Capstone2017-G4/411Practicum/Final BOM.pdf

# Bill Of Material

Component Name | Quantity | Per Unit Cost | Cost | Component Name | Quantity | Per Unit Cost | Cost
Resistors | | | | IC Bases
10k | 1 | $0.01 | $0.01 | 28-PIN | 1 | $0.50 | $0.50
750k | 1 | $0.01 | $0.01 | 18-Pin | 2 | $0.25 | $0.50
1M | 1 | $0.01 | $0.01 | 16-pin | 1 | $0.50 | $0.50
220 | 4 | $0.01 | $0.04 | 6-pin GPIO header | 1 | $0.50 | $0.50
47k | 1 | $0.01 | $0.01 | 2x3 6-pin ISP header | 1 | $0.50 | $0.50
Capacitors | | | | Miscellaneous
0.1u | 9 | $0.01 | $0.09 | CRYSTAL 16MHz | 1 | $0.24 | $0.24
10u | 6 | $0.01 | $0.06 | TX/RX module pair | 1 | $1.83 | $1.83
22p | 2 | $0.01 | $0.02 | RED LED | 2 | $0.10 | $0.20
Integrated Circuits | | | | 2-PIN PUSH BUTTON | 2 | $0.50 | $1.00
7805T | 2 | $0.20 | $0.40 | MALE BURGE 2-PIN | 1 | $0.50 | $0.50
ATMEGA ATMEL 328PU | 1 | $7.68 | $7.68 | PCB CONNECTOR 2-PIN | 4 | $0.50 | $2.00
L293D | 1 | $0.90 | $0.90 | ACCELEROMETER | 1 | $14.99 | $14.99
HT12E | 1 | $1.75 | $1.75 | Battery 9V | 10 | $3.00 | $30.00
HT12D | 1 | $1.95 | $1.95 | ROBOT CHASSIS W/ 2 MOTORS | 1 | $10.99 | $10.99
| | | | SOLDERING LED | 4 | $0.20 | $0.80
| | | | CONNECTING WIRE | 10 | $0.01 | $0.10
| | | | TOTAL | | $47.66 | $78.07
