Capstone2017-G4/411Practicum/Transmitter_11-16.brd

## EAGLE design Transmitter_11-16.brd (2017-11-16)

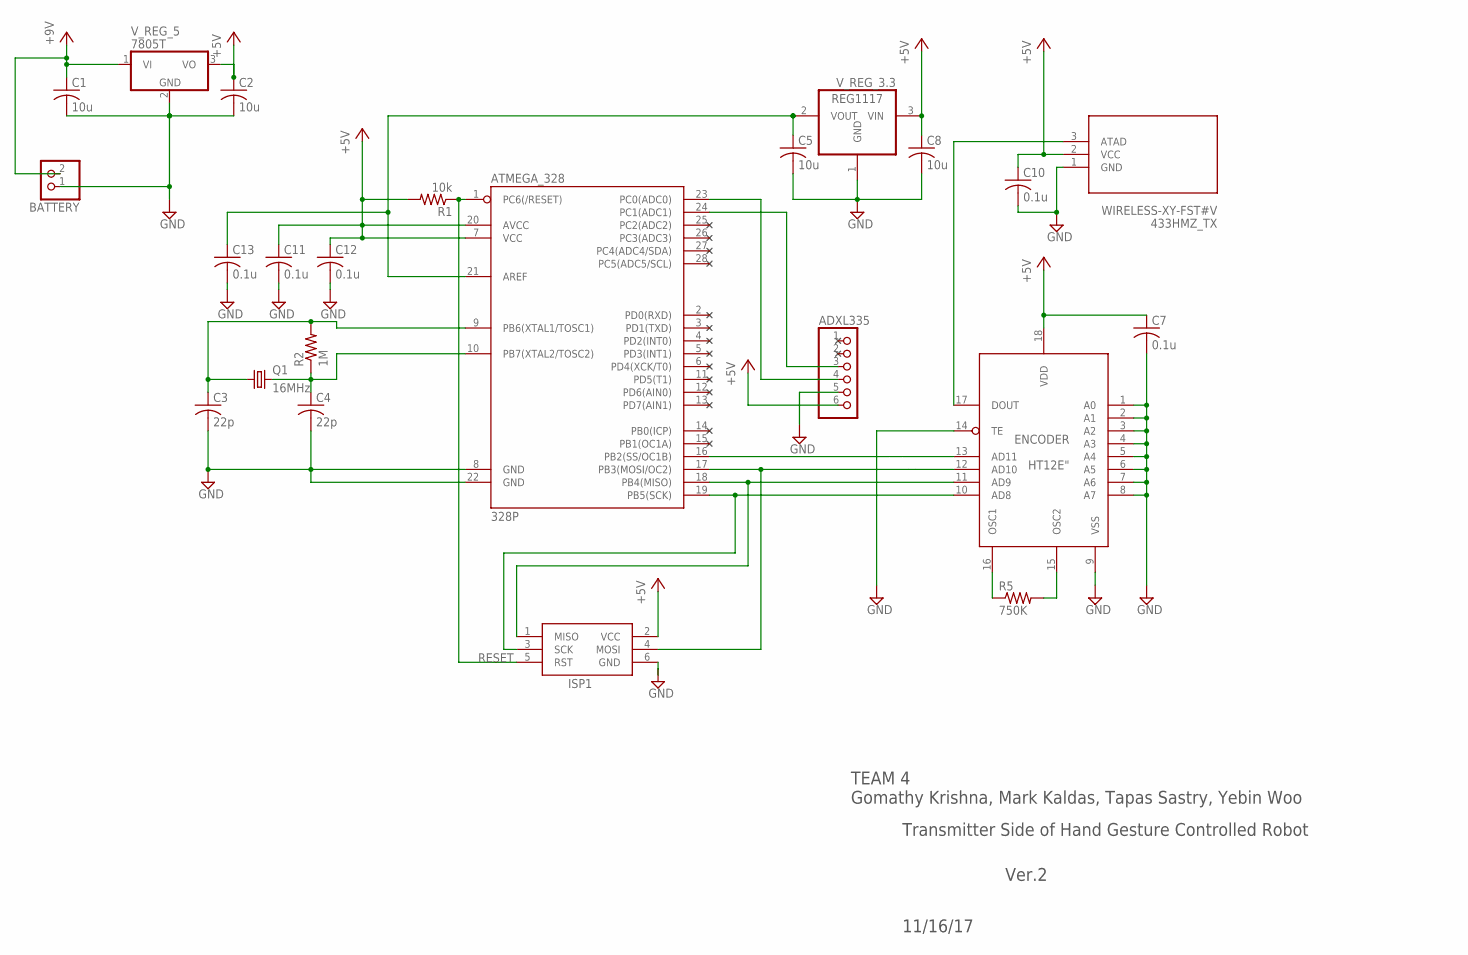
[picture p20: schematic Transmitter_11-16.sch]

Parts:
433HMZ_TX: WIRELESS-XY-FST#V
ADXL335: PINHD-1X6; 1X06
ATMEGA_328: 328P; DIP28
BATTERY: PINHD-1X2; 1X02
C1, C2, C5, C8: 10u; C0805
C3, C4: 22p; C0805
C7, C10, C11, C12, C13: 0.1u; C0805
ENCODER: HT12E"; 18-DIP-A
ISP1: AVRISP-6; AVRISP
Q1: 16MHz; HC49/S
R1: 10k; R0805
R2: 1M; R0805
R5: 750K; R0805
V_REG_3.3: REG1117; SOT223
V_REG_5: 7805T; TO220H

Connections:
+5V: 433HMZ_TX.2 (VCC), ADXL335.6, ATMEGA_328.7 (VCC), ATMEGA_328.20 (AVCC), C2.1, C7.1, C8.1, C10.1, C11.1, C12.1, ENCODER.18 (VDD), ISP1.2 (VCC), R1.2, V_REG_3.3.3 (VIN), V_REG_5.3 (VO)
AD08: ATMEGA_328.19 (PB5(SCK)), ENCODER.10 (AD8), ISP1.3 (SCK)
GND: 433HMZ_TX.1 (GND), ADXL335.5, ATMEGA_328.8 (GND), ATMEGA_328.22 (GND), BATTERY.1, C1.2, C2.2, C3.2, C4.2, C5.2, C7.2, C8.2, C10.2, C11.2, C12.2, C13.2, ENCODER.1 (A0), ENCODER.2 (A1), ENCODER.3 (A2), ENCODER.4 (A3), ENCODER.5 (A4), ENCODER.6 (A5), ENCODER.7 (A6), ENCODER.8 (A7), ENCODER.9 (VSS), ENCODER.14 (TE), ISP1.6 (GND), V_REG_3.3.1 (GND), V_REG_5.2 (GND)
unnamed: ATMEGA_328.9 (PB6(XTAL1/TOSC1)), C3.1, Q1.1, R2.2
unnamed: ATMEGA_328.18 (PB4(MISO)), ENCODER.11 (AD9), ISP1.1 (MISO)
unnamed: ADXL335.4, ATMEGA_328.23 (PC0(ADC0))
unnamed: ATMEGA_328.10 (PB7(XTAL2/TOSC2)), C4.1, Q1.2, R2.1
unnamed: ENCODER.16 (OSC1), R5.1
unnamed: ENCODER.15 (OSC2), R5.2
unnamed: 433HMZ_TX.3 (ATAD), ENCODER.17 (DOUT)
unnamed: ATMEGA_328.16 (PB2(SS/OC1B)), ENCODER.13 (AD11)
unnamed: ATMEGA_328.17 (PB3(MOSI/OC2)), ENCODER.12 (AD10), ISP1.4 (MOSI)
unnamed: ADXL335.3, ATMEGA_328.24 (PC1(ADC1))
unnamed: ATMEGA_328.21 (AREF), C5.1, C13.1, V_REG_3.3.2 (VOUT)
RESET: ATMEGA_328.1 (PC6(/RESET)), ISP1.5 (RST), R1.1
VCC: BATTERY.2, C1.1, V_REG_5.1 (VI)

Notes on the sheet:
Transmitter Side of Hand Gesture Controlled Robot
TEAM 4 Gomathy Krishna, Mark Kaldas, Tapas Sastry, Yebin Woo
Ver.2
11/16/17

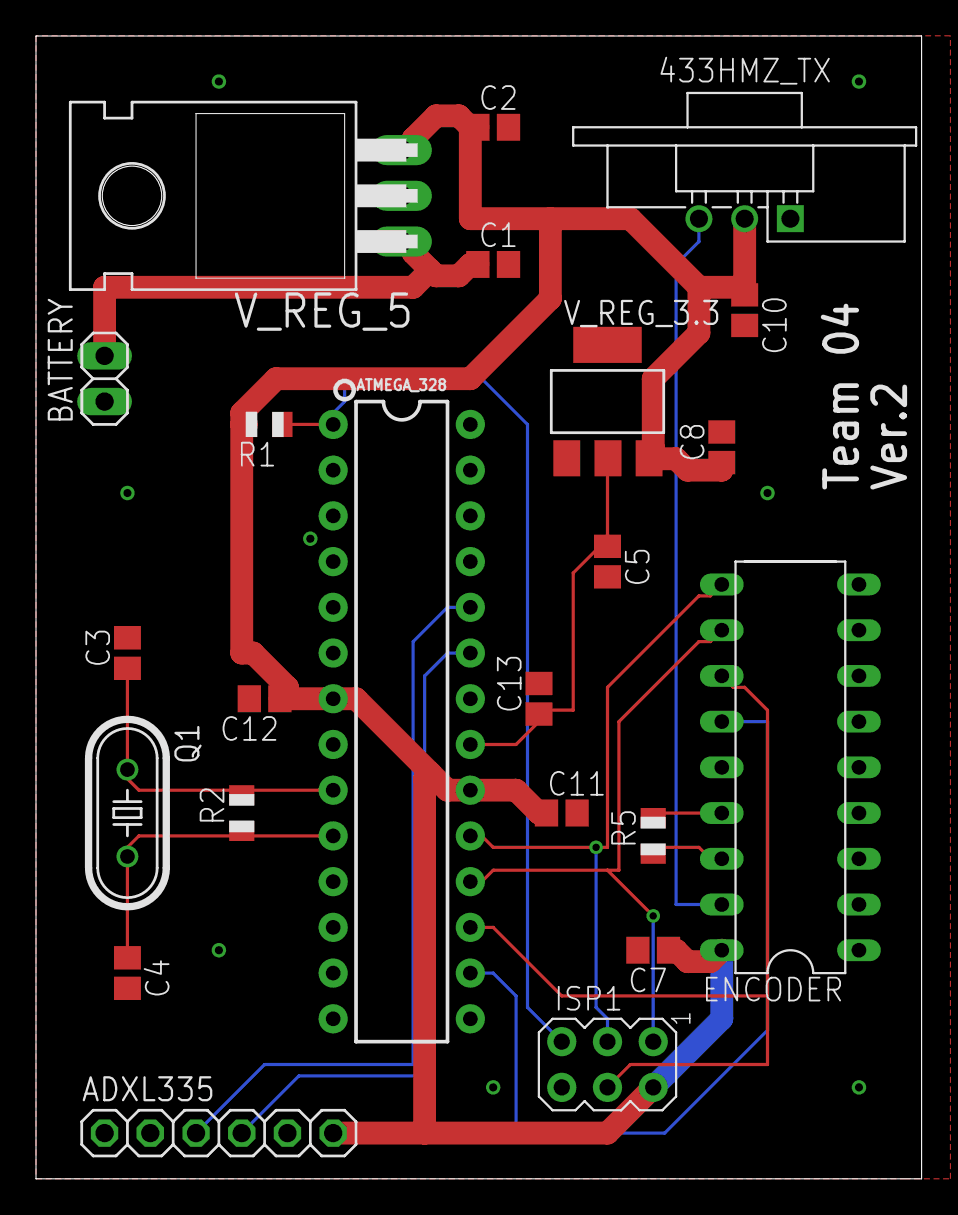
[picture p21: board Transmitter_11-16.brd from above]

Board: 2 copper layers, 49.2 x 63.5 mm, 23 parts (0 on the bottom side), 16 nets.
