Capstone2017-G4/411Practicum/Reciever_11-16.brd

## EAGLE design Reciever_11-16.brd (2017-11-16)

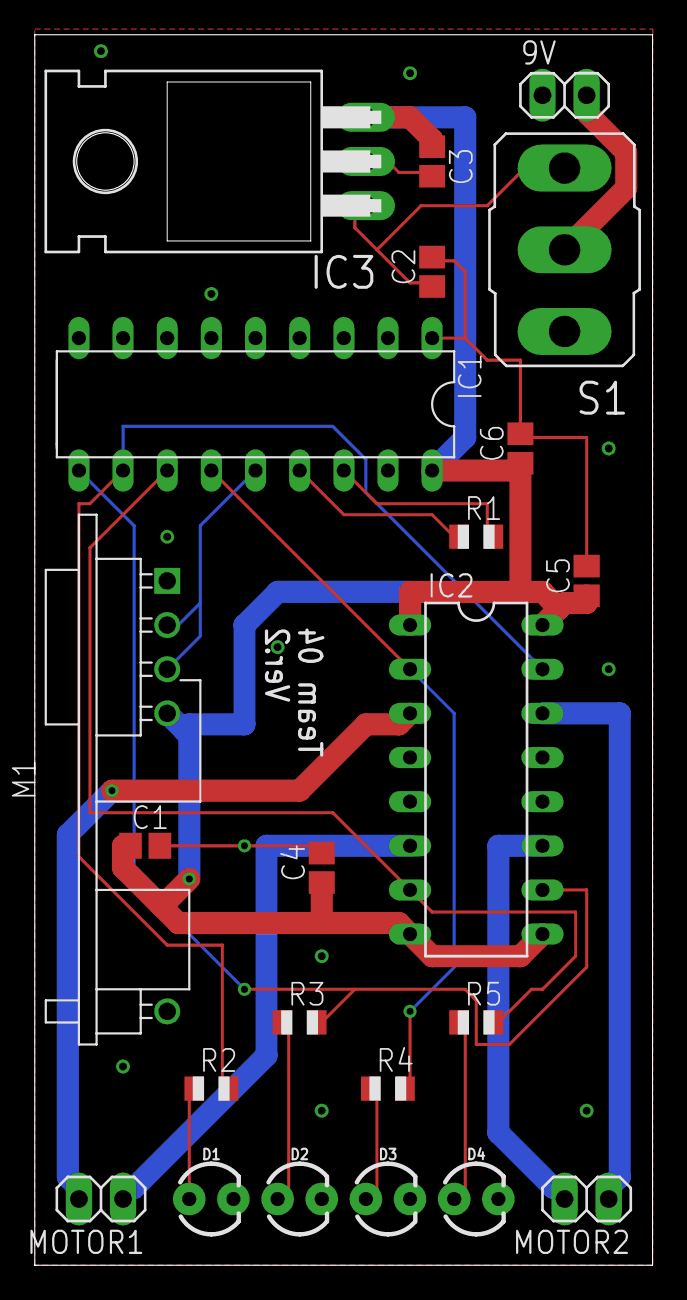
[picture p22: board Reciever_11-16.brd from above]

Board: 2 copper layers, 35.5 x 70.8 mm, 23 parts (0 on the bottom side), 19 nets.

Parts:
9V: 1X02
C1, C4, C5, C6: 0.1u; C0805
C2, C3: 10u; C0805
D1, D2, D3, D4: LED_3MM
IC1: HT12D"; 18-DIP-A
IC2: L293D; DIL16
IC3: 7805T; TO220H
M1: WIRELESS-XY-MK-5V-V; WIRELESS-XY-MK-5V#V
MOTOR1, MOTOR2: 1X02
R1: 47k; R0805
R2, R3, R4, R5: 220; R0805
S1: M9040P

Connections:
+5V: C1.1, C3.1, C4.1, C5.1, C6.1, IC1.18, IC2.1, IC2.8, IC2.9, IC2.16, IC3.3, M1.4
+LEFT: IC2.3, MOTOR1.2
+RIGHT: IC2.14, MOTOR2.1
-LEFT: IC2.6, MOTOR1.1
-RIGHT: IC2.11, MOTOR2.2
DIN: IC1.14, M1.2, M1.3
GND: 9V.1, C1.2, C2.2, C3.2, C4.2, C5.2, C6.2, D1.K, D2.K, D3.K, D4.K, IC1.1, IC1.2, IC1.3, IC1.4, IC1.5, IC1.6, IC1.7, IC1.8, IC1.9, IC2.4, IC2.5, IC2.12, IC2.13, IC3.2, M1.1
unnamed: IC1.16, R1.2
unnamed: IC1.10, IC2.10, R3.2
unnamed: IC1.15, R1.1
unnamed: D1.A, R2.1
unnamed: IC1.11, IC2.15, R2.2
unnamed: IC1.12, IC2.7, R5.2
unnamed: IC1.13, IC2.2, R4.2
unnamed: 9V.2, S1.2
unnamed: D2.A, R3.1
unnamed: D3.A, R4.1
unnamed: D4.A, R5.1
unnamed: C2.1, IC3.1, S1.3
