Capstone2017-G4/411Practicum/Transmitter_Final(11-13).brd

## EAGLE design Transmitter_Final(11-13).brd (2017-11-14)

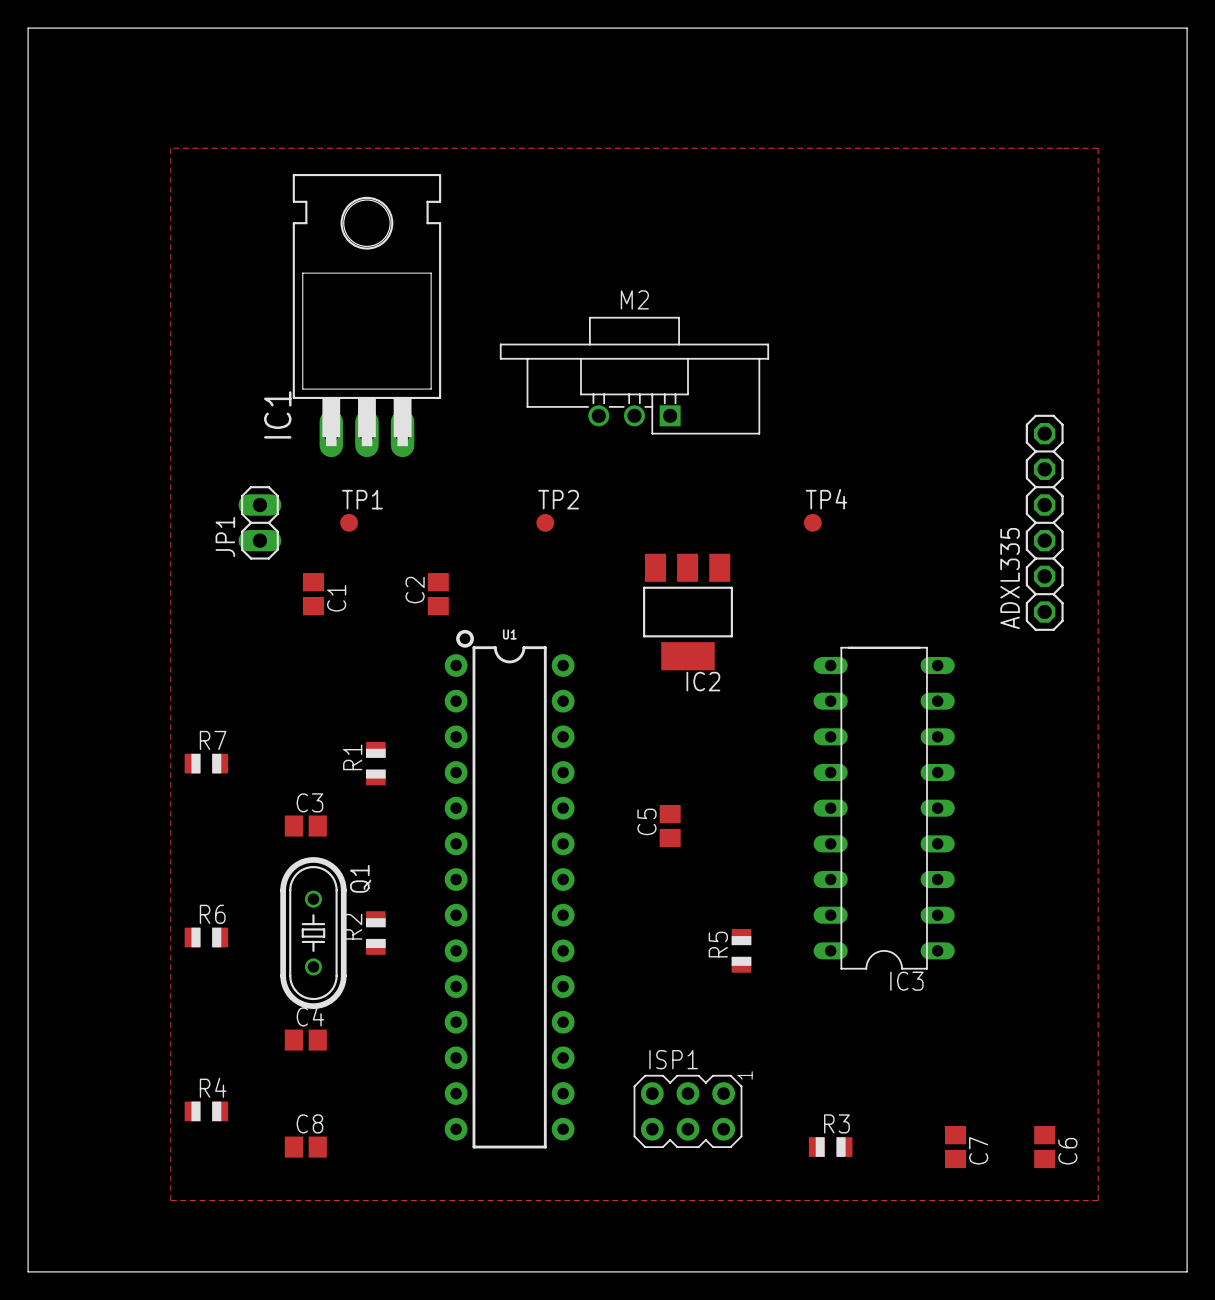
[picture p23: board Transmitter_Final(11-13).brd from above]

Board: 2 copper layers, 82.5 x 88.6 mm, 27 parts (0 on the bottom side), 18 nets, no tracks yet.

Parts:
ADXL335: 1X06
C1, C2, C6, C7, C8: 0.1u; C0805
C3, C4: 22p; C0805
C5: 10u; C0805
IC1: 7805T; TO220H
IC2: REG1117; SOT223
IC3: HT12E"; 18-DIP-A
ISP1: AVRISP-6; AVRISP
JP1: 1X02
M2: WIRELESS-XY-FST#V
Q1: 16MHz; HC49/S
R1, R3, R4, R6, R7: 10k; R0805
R2: 1M; R0805
R5: 750K; R0805
TP1, TP2, TP4: TPB1,27; B1,27
U1: 328P; DIP28

Connections:
+5V: ADXL335.6, C2.1, C6.1, C7.1, IC1.3, M2.2, R1.2, R3.1, R4.2, R6.1, R6.2, R7.1, U1.7, U1.20
AD08: IC3.10, ISP1.3, U1.19
AREF: C5.1, IC2.2, TP2.TP, U1.21
unnamed: C3.1, Q1.1, R2.2, U1.9
unnamed: IC3.11, ISP1.1, U1.18
unnamed: ADXL335.4, U1.23
unnamed: C4.1, Q1.2, R2.1, U1.10
unnamed: IC3.16, R5.1
unnamed: IC3.15, R5.2
unnamed: ISP1.2, R3.2
unnamed: IC3.13, U1.16
unnamed: IC3.12, ISP1.4, U1.17
unnamed: IC2.3, R7.2
unnamed: ADXL335.3, U1.24
unnamed: IC3.17, M2.3, TP4.TP
unnamed: ADXL335.5, C1.2, C2.2, C3.2, C4.2, C5.2, C6.2, C7.2, C8.1, C8.2, IC1.2, IC2.1, IC3.1, IC3.2, IC3.3, IC3.4, IC3.5, IC3.6, IC3.7, IC3.8, IC3.9, IC3.14, IC3.18, ISP1.6, JP1.1, M2.1, R4.1, TP1.TP, U1.8, U1.22
RESET: ISP1.5, R1.1, U1.1
VCC: C1.1, IC1.1, JP1.2
