Capstone2017-G4/411Practicum/(commit log)

2017-11-16 new edits 11-15
    [Transmitter_Final(11-13).brd, Transmitter_Final(11-13).sch]
2017-11-16 16/11 Receiver file: need to check 16th 8am
    [Reciever_11-16.brd, Reciever_11-16.sch]
2017-11-16 16/11 transmitter file: need to check 16th 8am
    [Transmitter_11-16.brd, Transmitter_11-16.sch]
2017-11-16 Final Schematic and Board files for OSHPark
    [ece411-t4-rx-hand-controlled-robot.brd, ece411-t4-rx-hand-controlled-robot.sch, ece411-t4-tx-hand-controlled-robot.brd, ece411-t4-tx-hand-controlled-robot.sch]
2017-11-30 prototype code that is working
2017-11-30 prototype code
2017-11-30 rev1 of prototype test code
